sfg-autonomous-systems/sfg_vicon_object_calibration/assets/marker_tree_base.step

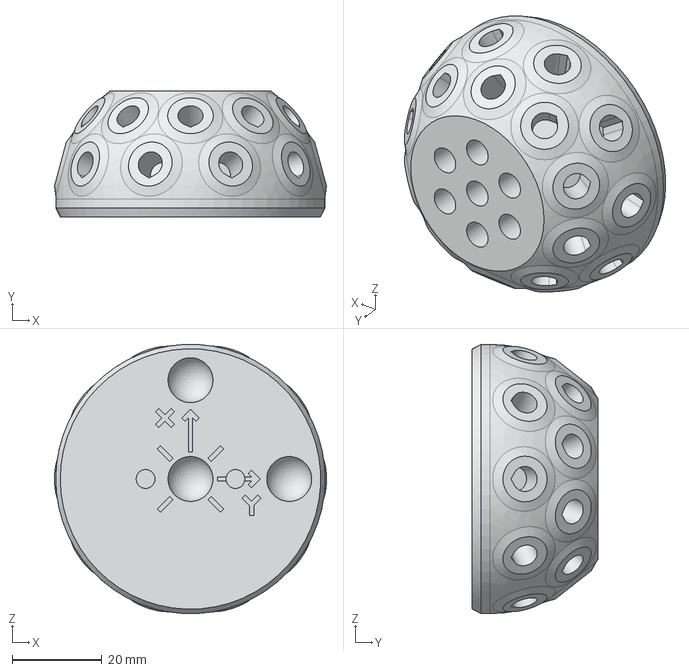
[picture p1: CAD file, 2026-10-13]
assets/marker_tree_base.step
60.6 x 28.0 x 59.9 mm
