sfg-autonomous-systems/sfg_vicon_object_calibration/(list of files, cad)

Other CAD files:
scans/sfg_go2_01.stl
