sfg-autonomous-systems/sfg_vicon_object_calibration/(commit log)

2026-10-13 feature: Add origin calibration object script and shared helpers.
    - Add compute_origin_calibration_object_markers.py, which expresses the
    scanned plate markers in a marker-defined frame for the Vicon Tracker
    calibration object .vsk.
    - Move shared code into scripts/common.py.
    - Document the workflow in the README and add assets.
    - Pin the Qt build of vtk-base; the OSMesa build no longer loads.
    - Ignore __pycache__/.
2026-10-13 feature: Add sfg_go2_01__tracker scan and update its config.
    - Add the sfg_go2_01__tracker scan and
    updated config/sfg_go2_01__tracker.yaml with the marker and base
    positions taken from it.
    - Add the origin calibration object scan.
    - Track *.stl files with Git LFS.
    - Print markers with fixed-width formatting in print_available_markers
    and type the marker lists as list[numpy.ndarray].
